viesturz/TapChanger-lite/README.md

# Tapchanger lite

Tapchanger lite is now the main [Tapchanger](https://github.com/viesturz/tapchanger), it's better in all ways and continues in the main repo.
