viesturz/TapChanger-lite/Images/dock.jpg

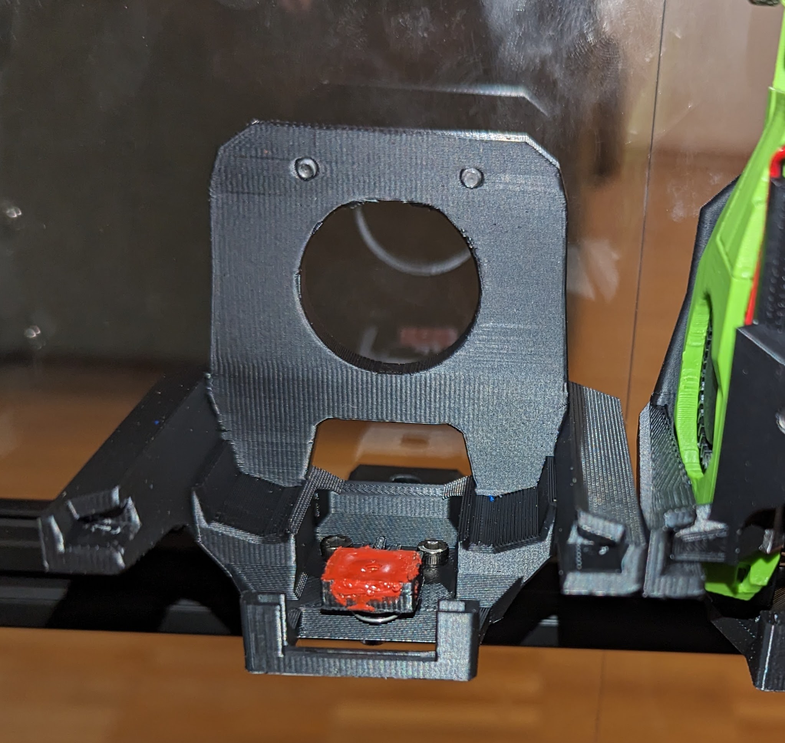
Images/dock.jpg
