viesturz/TapChanger-lite/Images/endstop_hub.jpg

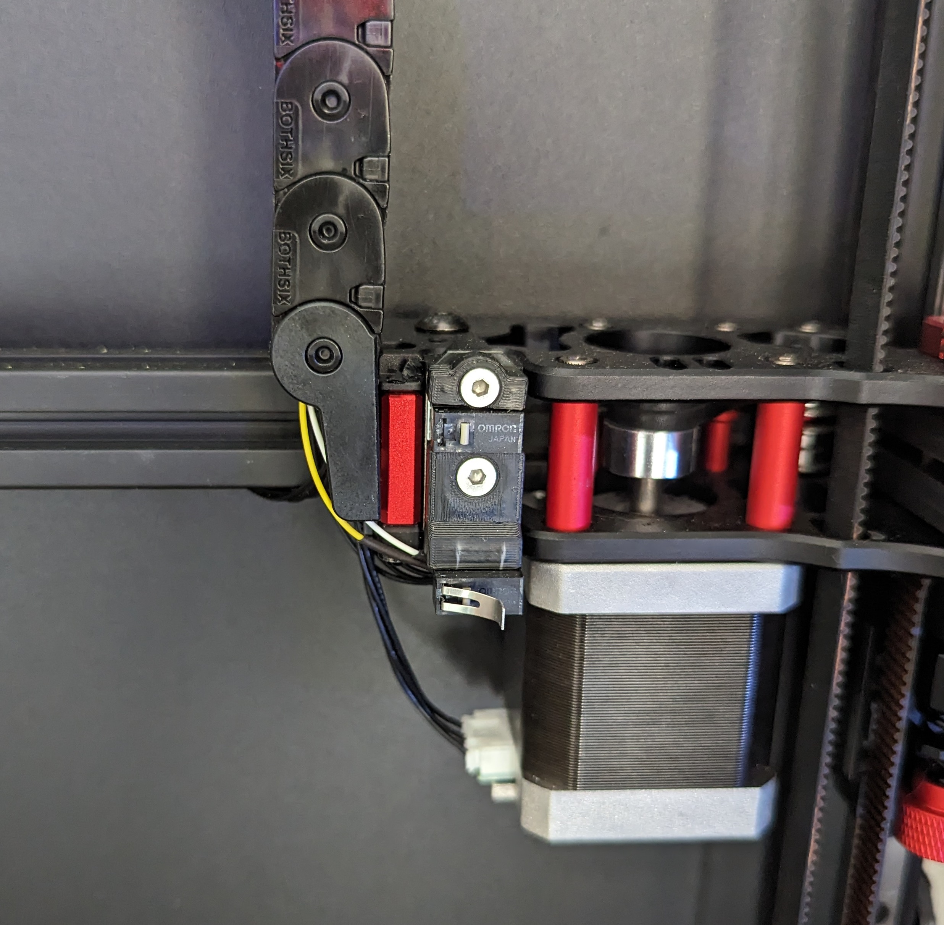
Images/endstop_hub.jpg
