viesturz/TapChanger-lite/Images/plate.jpg

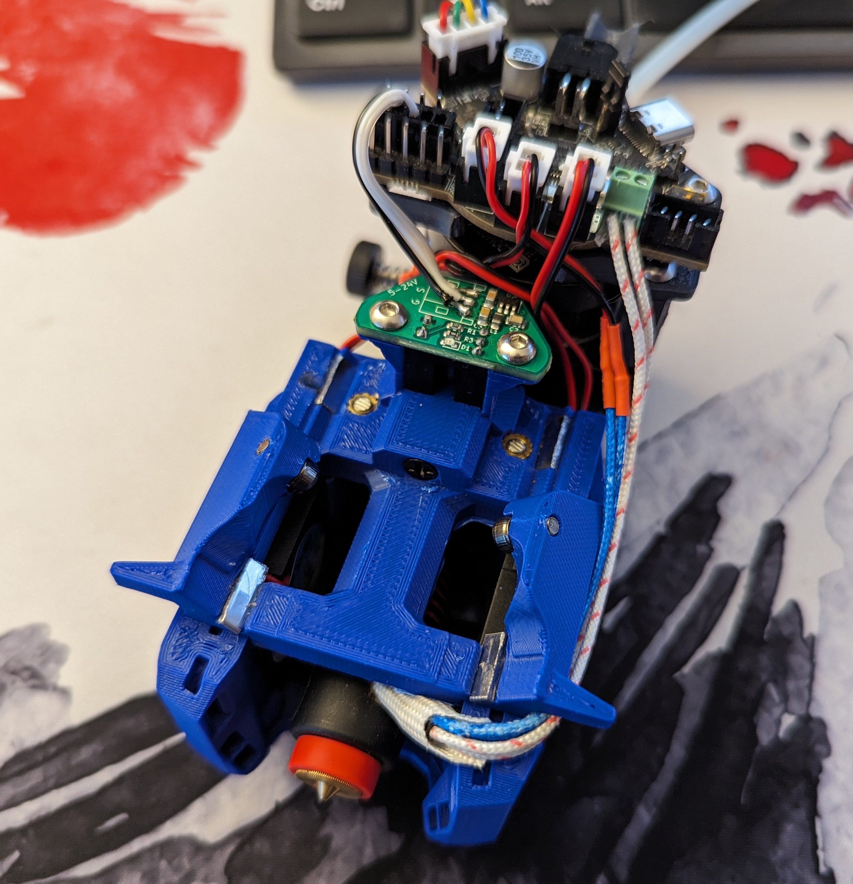
Images/plate.jpg
