viesturz/TapChanger-lite/Images/shuttle.jpg

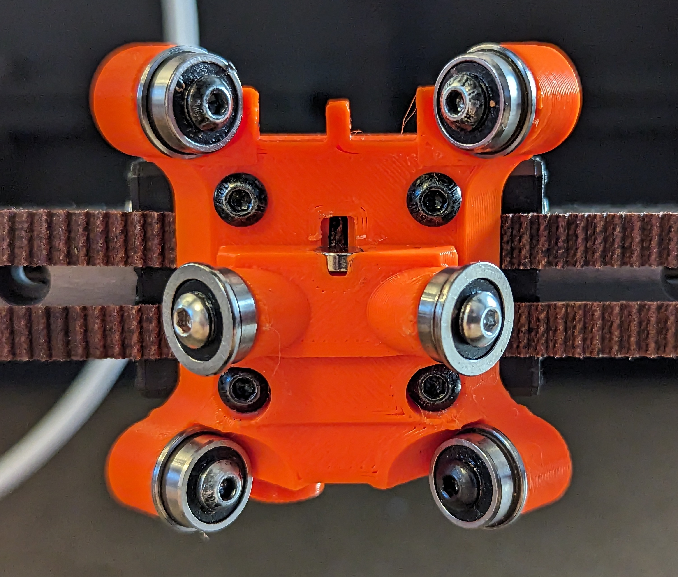
Images/shuttle.jpg
