viesturz/TapChanger-lite/STL/Endstops/HallSensor.stl

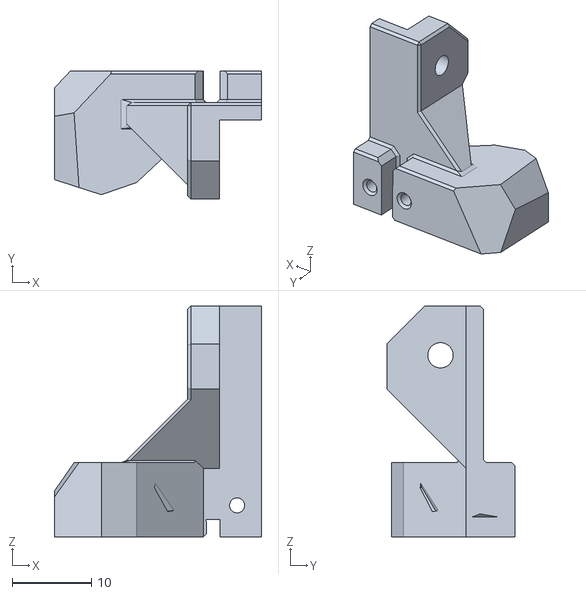
[picture p9: CAD file, 2023-08-19]
STL/Endstops/HallSensor.stl
26.2 x 16.2 x 29.2
