viesturz/TapChanger-lite/STL/MiniSB/Mount-rods.stl

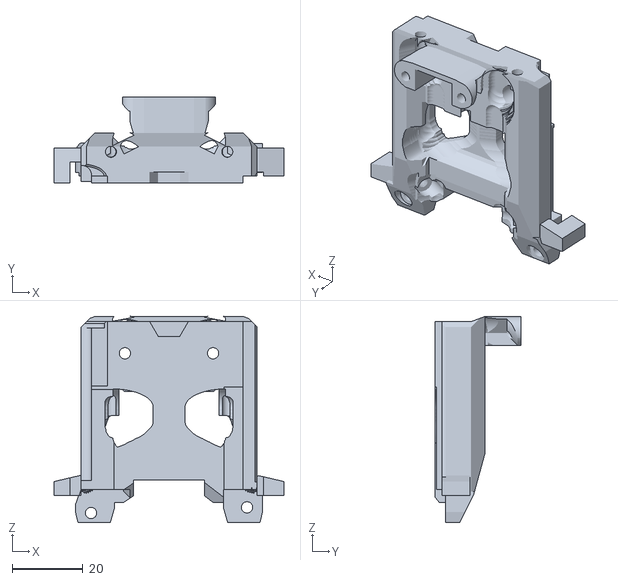
[picture p10: CAD file, 2023-09-16]
STL/MiniSB/Mount-rods.stl
65.2 x 24.4 x 58.5
