viesturz/TapChanger-lite/STL/Misc/RodCuttingJig2.stl

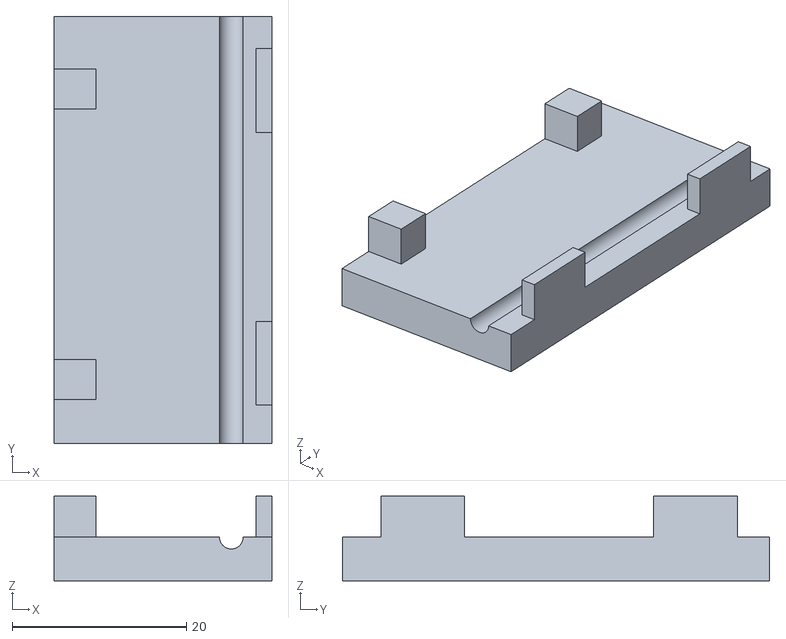
[picture p11: CAD file, 2023-08-30]
STL/Misc/RodCuttingJig2.stl
25.0 x 49.0 x 9.70
