viesturz/TapChanger-lite/STL/SB/Mount-rods.stl

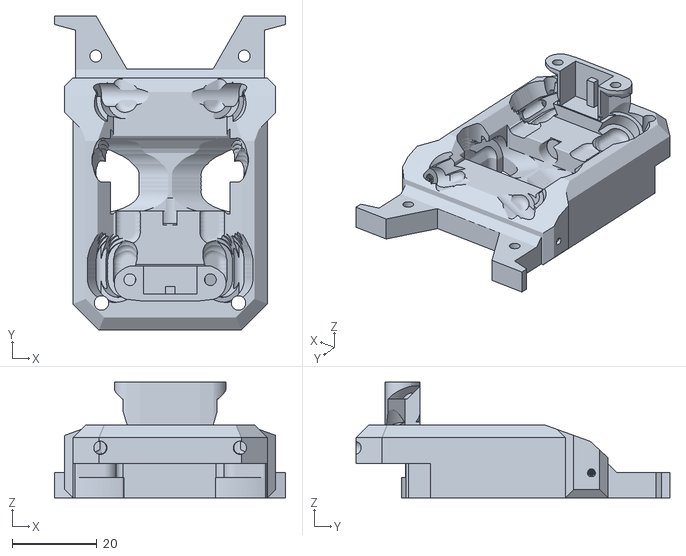
[picture p12: CAD file, 2023-09-16]
STL/SB/Mount-rods.stl
54.7 x 74.2 x 27.4
