viesturz/TapChanger-lite/STL/Shuttle/Shuttle-rods-thruholes.stl

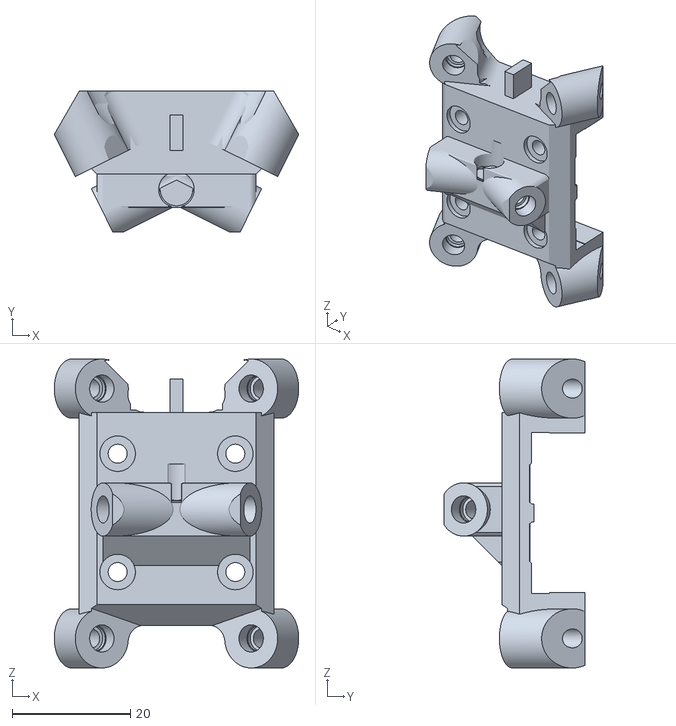
[picture p13: CAD file, 2023-09-16]
STL/Shuttle/Shuttle-rods-thruholes.stl
41.3 x 23.8 x 52.2
