viesturz/TapChanger-lite/STL/Endstops/ProbeHub Bottom Cap.stl

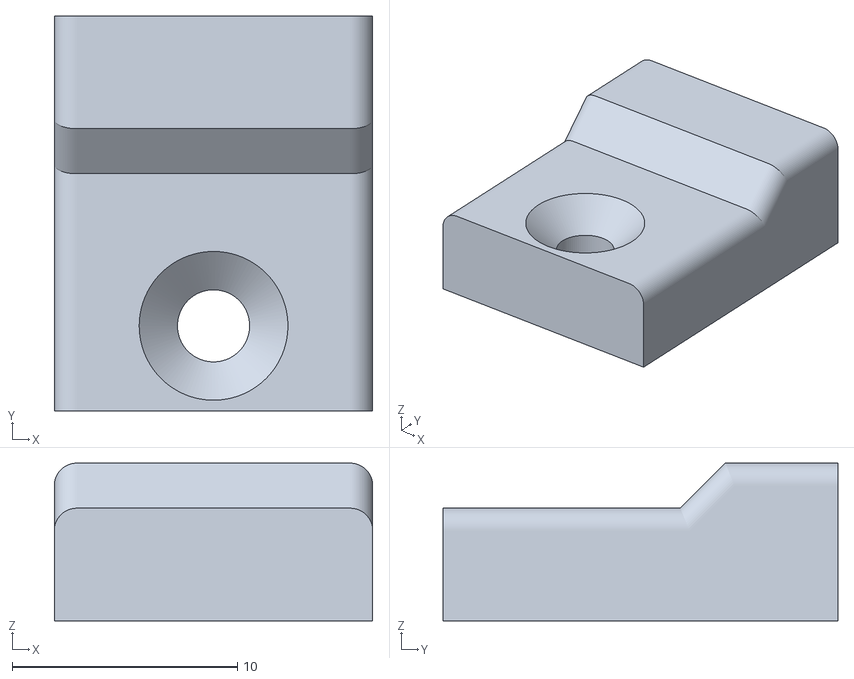
[picture p14: CAD file, 2023-07-01]
STL/Endstops/ProbeHub Bottom Cap.stl
14.1 x 17.5 x 7.00
