viesturz/TapChanger-lite/STL/MiniSB/Dock.stl

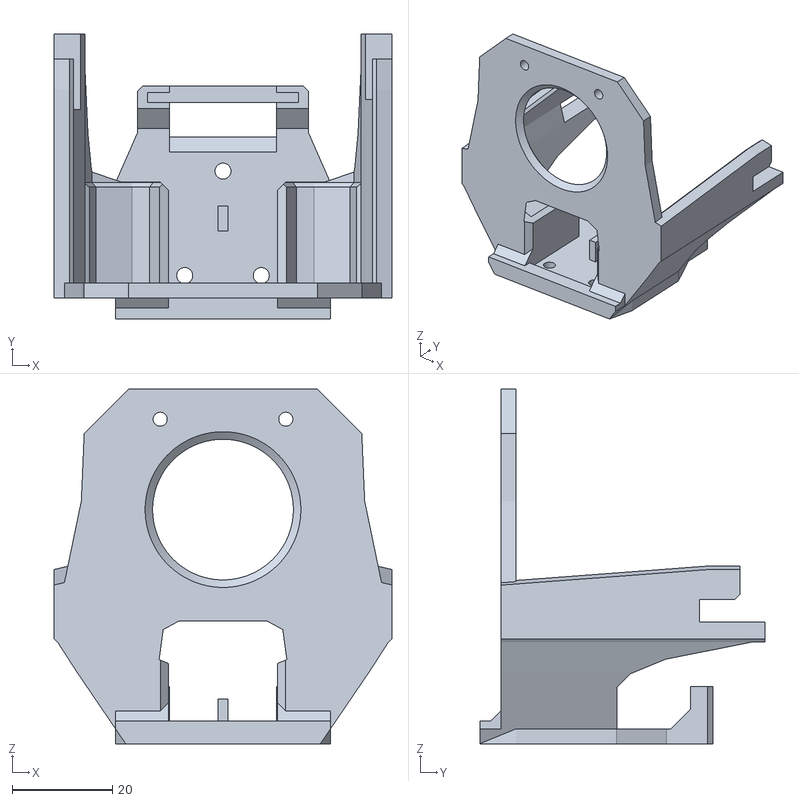
[picture p15: CAD file, 2023-07-29]
STL/MiniSB/Dock.stl
67.2 x 56.7 x 70.7
