viesturz/TapChanger-lite/STL/Misc/RodCuttingJig1.stl

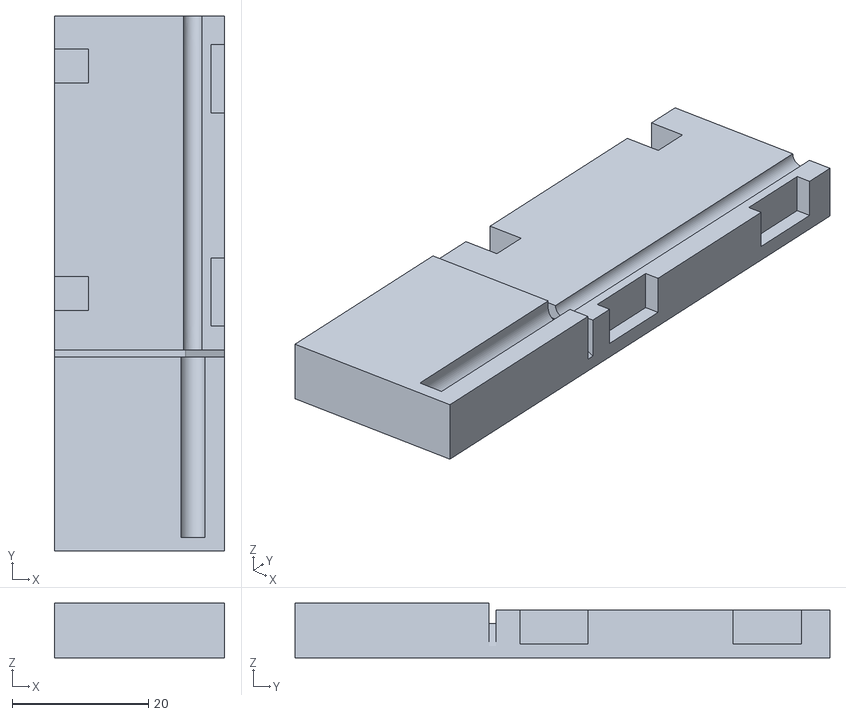
[picture p16: CAD file, 2023-08-30]
STL/Misc/RodCuttingJig1.stl
25.0 x 78.5 x 8.00
