viesturz/TapChanger-lite/STL/Shuttle/Shuttle-rods.stl

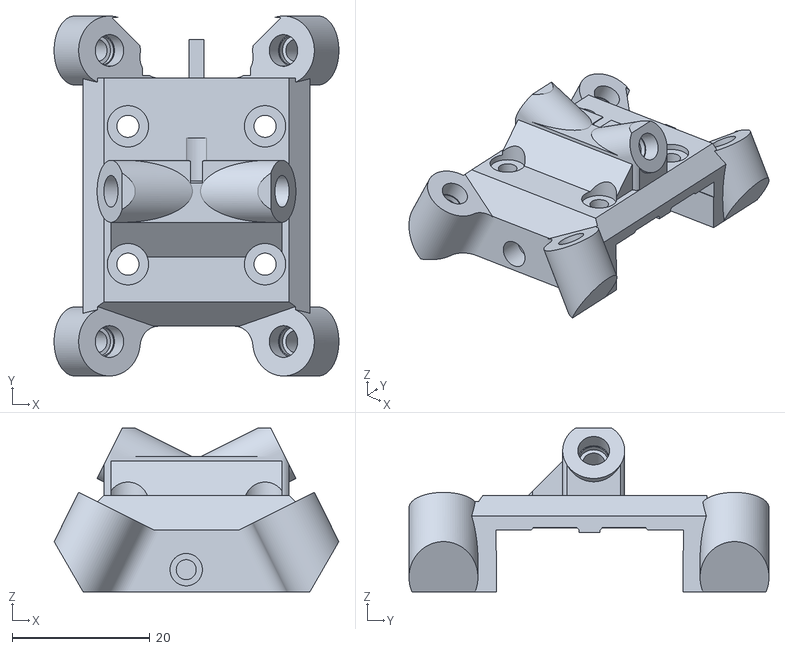
[picture p17: CAD file, 2023-09-16]
STL/Shuttle/Shuttle-rods.stl
41.3 x 52.2 x 23.8
