viesturz/TapChanger-lite/STL/Endstops/ProbeHub Top Cap.stl

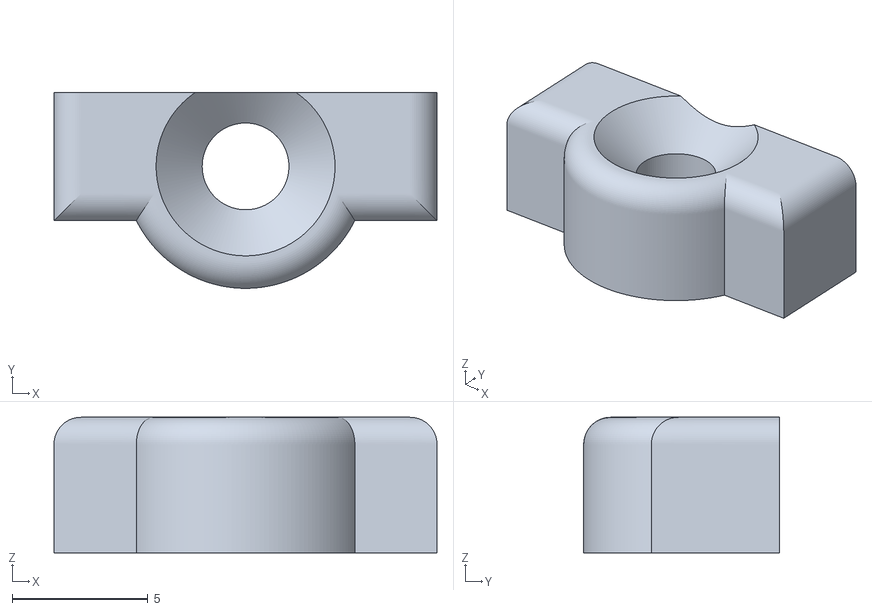
[picture p18: CAD file, 2023-07-01]
STL/Endstops/ProbeHub Top Cap.stl
14.1 x 7.22 x 5.00
