viesturz/TapChanger-lite/STL/MiniSB/Mount-pads.stl

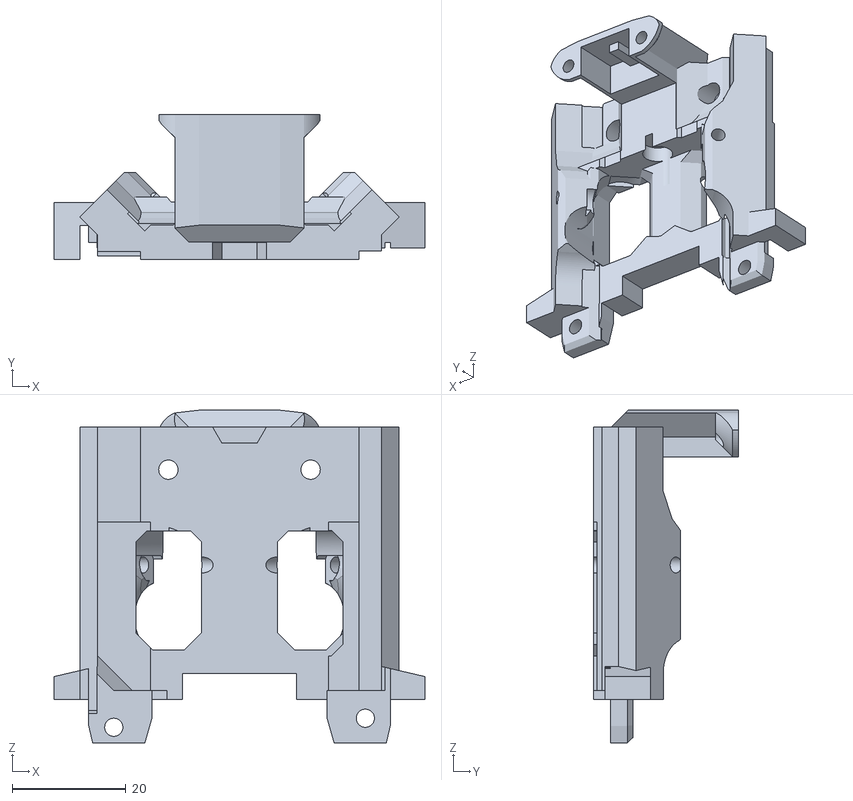
[picture p19: CAD file, 2023-07-01]
STL/MiniSB/Mount-pads.stl
65.2 x 25.4 x 58.5
