viesturz/TapChanger-lite/STL/Misc/PlateCuttingJig1.stl

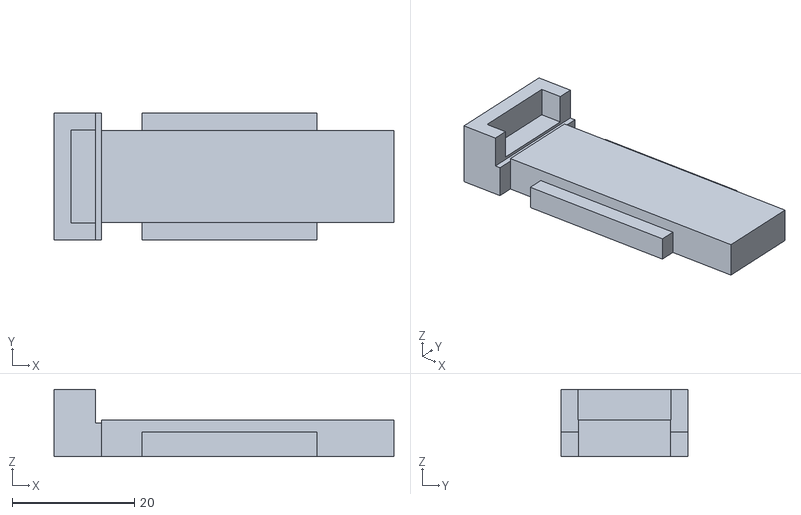
[picture p20: CAD file, 2023-07-29]
STL/Misc/PlateCuttingJig1.stl
55.6 x 20.8 x 11.0
