viesturz/TapChanger-lite/STL/SB/Dock.stl

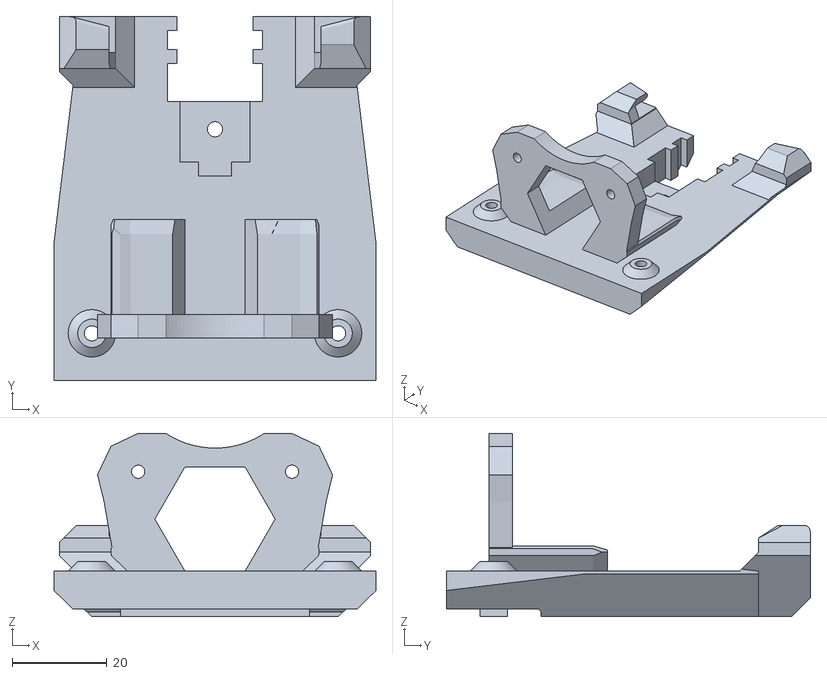
[picture p21: CAD file, 2023-07-29]
STL/SB/Dock.stl
68.0 x 76.9 x 38.7
