viesturz/TapChanger-lite/STL/Shuttle/Shuttle-pads.stl

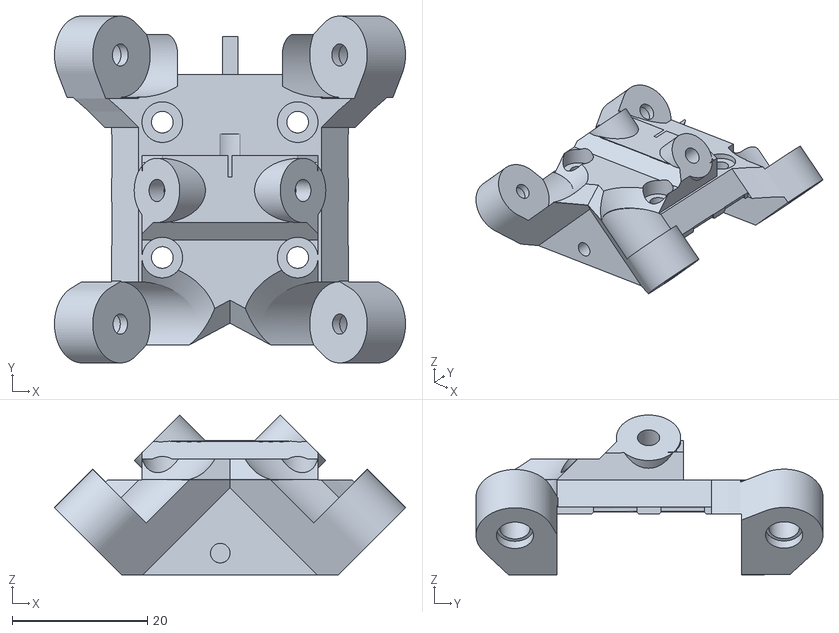
[picture p22: CAD file, 2023-07-01]
STL/Shuttle/Shuttle-pads.stl
51.9 x 51.3 x 23.6
