viesturz/TapChanger-lite/STL/Endstops/ProbeHub-Base.stl

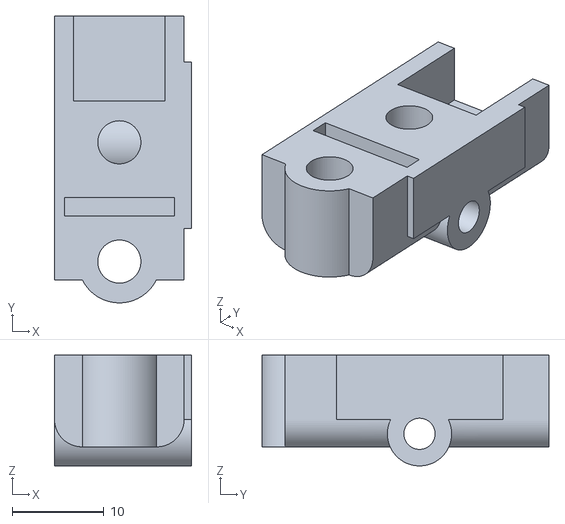
[picture p23: CAD file, 2023-07-01]
STL/Endstops/ProbeHub-Base.stl
14.9 x 31.2 x 12.1
