viesturz/TapChanger-lite/STL/MiniSB/DockMount.stl

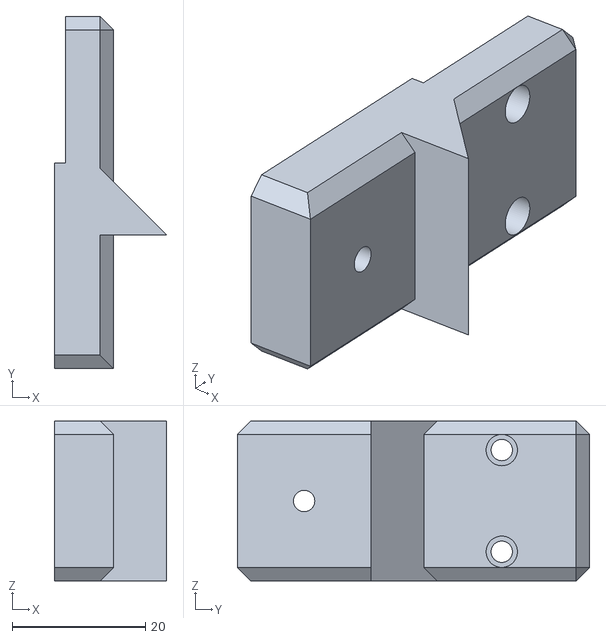
[picture p24: CAD file, 2023-06-28]
STL/MiniSB/DockMount.stl
16.9 x 52.8 x 24.0
