viesturz/TapChanger-lite/STL/Misc/PlateCuttingJig2.stl

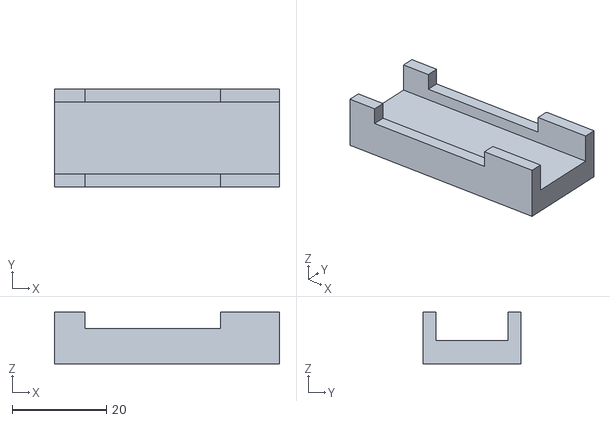
[picture p25: CAD file, 2023-07-29]
STL/Misc/PlateCuttingJig2.stl
47.8 x 20.8 x 11.0
