viesturz/TapChanger-lite/STL/SB/DockNozzlePad.stl

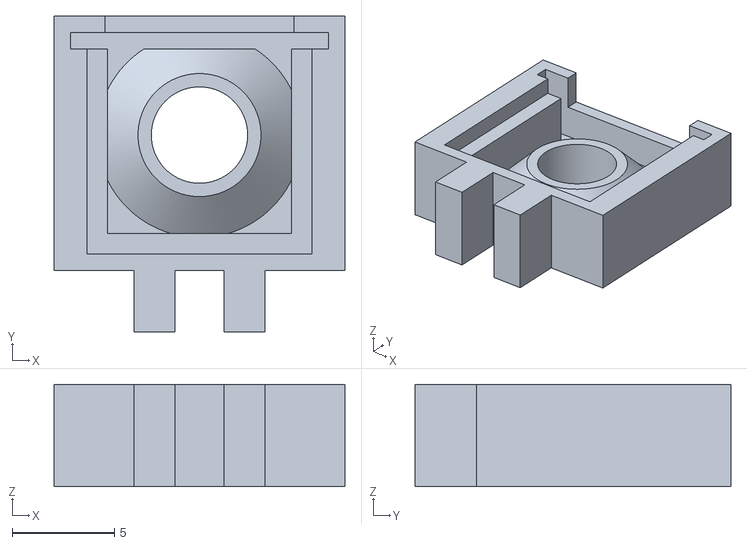
[picture p26: CAD file, 2023-06-25]
STL/SB/DockNozzlePad.stl
14.2 x 15.4 x 5.00
