viesturz/TapChanger-lite/STL/Endstops/X Endstop Lever.stl

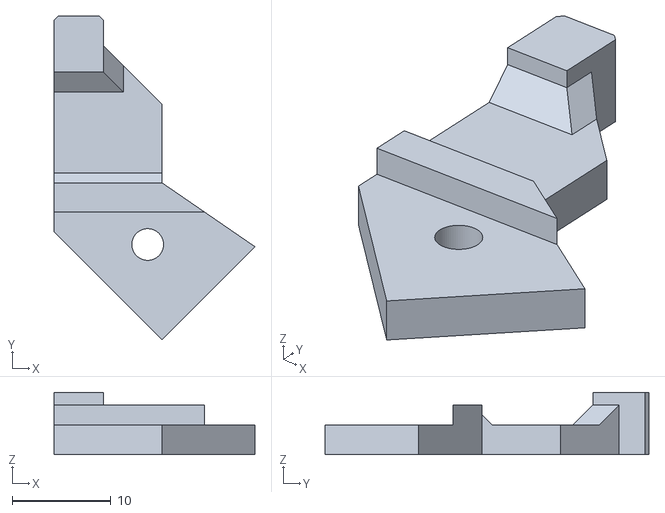
[picture p27: CAD file, 2023-06-25]
STL/Endstops/X Endstop Lever.stl
20.3 x 32.7 x 6.30
