viesturz/TapChanger-lite/STL/MiniSB/Front Cowling.stl

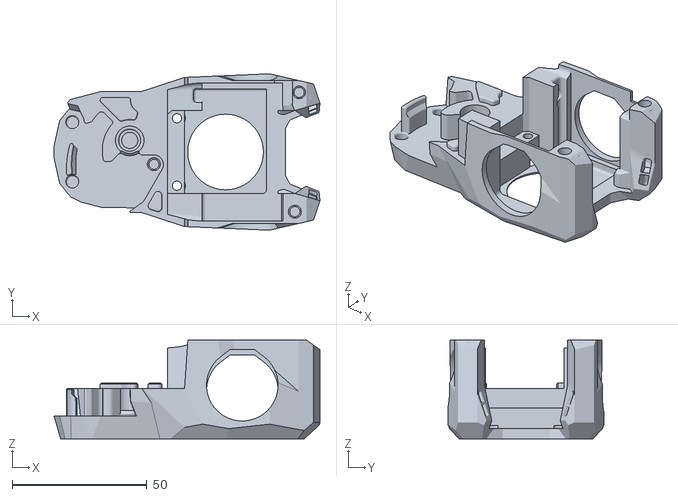
[picture p28: CAD file, 2023-06-28]
STL/MiniSB/Front Cowling.stl
98.6 x 57.9 x 36.5
