viesturz/TapChanger-lite/STL/MiniSB/Front Cowling-Orbiter 2.0.stl

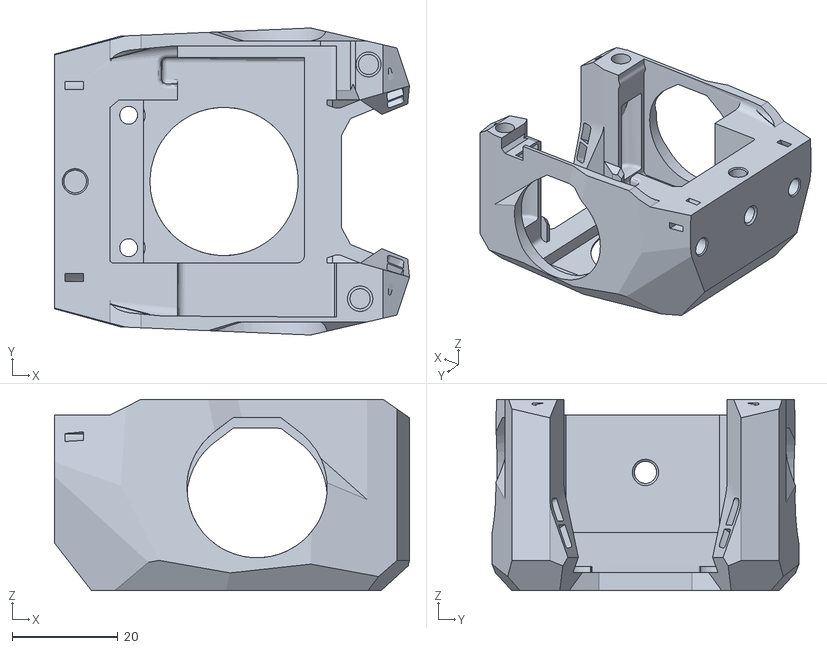
[picture p29: CAD file, 2023-06-28]
STL/MiniSB/Front Cowling-Orbiter 2.0.stl
67.0 x 57.9 x 36.1
