viesturz/TapChanger-lite/(list of files, cad)

Other CAD files:
STL/SB/Mount-pads.stl
STL/MiniSB/DockNozzlePad.stl
