viesturz/TapChanger-lite/(commit log)

2023-06-09 First rev
    [Dock-MiniSB.stl, DockMount-MiniSB.stl, Mount-MiniSB.stl, Shuttle.stl, XEndstop.stl]
2023-06-11 Small cleanups to shuttle.
    [Shuttle.stl]
2023-06-14 Minor rigidity updates, optional bottom screws into the cowling.
    [DockMount-MiniSB.stl, Front Cowling.stl]
2023-06-20 Minor updates to dock and plate.
    [Dock-MiniSB.stl, Dock.stl, DockMount-MiniSB.stl, DockMount.stl, Mount-MiniSB.stl, MountPlate.stl, Shuttle.stl]
2023-06-22 Unified mount - first attempt
    [Dock.stl, DockNozzlePad.stl, Front Cowling-Orbiter 2.0.stl, MountPlate.stl, Plate.stl, Shuttle.stl]
2023-06-24 This should work
    [DockBase_Lower.stl, DockBase_Upper.stl, DockNozzlePad.stl, Front Cowling.stl, MountPlate.stl, Plate.stl, Shuttle.stl, XEndstop.stl]
2023-06-24 Smaller Mini dock with magnets embedded in the cowling
    [Dock-Small.stl, Front Cowling.stl]
2023-06-25 Simplified dock for SB
    [Dock.stl, MountPlate.stl, Plate.stl, Shuttle.stl]
2023-06-25 Update orbiter, readme.
    [Front Cowling-Orbiter 2.0.stl]
2023-06-26 Longer sensor pin
    [Front Cowling-Orbiter 2.0.stl, MountPlate.stl, Plate.stl, Shuttle.stl]
2023-06-28 Tweaks for better printability, go back to the high mini dock, the small one is too flimsy.
    [Dock.stl, DockMount.stl, Front Cowling-Orbiter 2.0.stl, Front Cowling.stl, MountPlate.stl, Plate.stl, Shuttle.stl]
2023-07-01 Tighter heatset insert radius for shuttle bearings. The 45deg angle stretches out the standard radius.
    [Shuttle.stl]
2023-07-01 Fix plate bug.
    [MountPlate.stl, Plate.stl]
2023-07-01 1.1 - final fixes and add config.
    [Dock.stl, MountPlate.stl, Plate.stl, ProbeHub Bottom Cap.stl, ProbeHub Top Cap.stl, ProbeHub-Base.stl, X Endstop Lever.stl, XEndstop.stl]
2023-07-01 Update Print Guide.md
2023-07-02 Dock tweaks
    [Dock.stl]
2023-07-05 Fix SB hole sizes
    [Plate.stl]
2023-07-08 Migrate config to https://github.com/viesturz/klipper/tree/toolchanger
    [calibrate-offsets.cfg, homing.cfg, macros.cfg, mcu-mini-T0.cfg, mcu-mini-T1.cfg, mcu-mini-plain-T3.cfg, mcu-sb-T2.cfg, mcu.cfg]
2023-07-29 Updated SB dock + Plate cutting jig
    [Dock.stl, DockBase_Lower.stl, DockBase_Upper.stl, PlateCuttingJig1.stl, PlateCuttingJig2.stl]
2023-07-29 Add some tolerance for supported area, otherwise this is very tight fit.
    [Plate.stl]
2023-08-19 Add hall X sensor mount
    [HallSensor.stl]
2023-08-19 Orientation fix
    [HallSensor.stl]
2023-08-20 Testing rods.
    [Mount.stl, Shuttle.stl]
2023-08-22 Tweks for better fit.
    [Mount.stl, Shuttle.stl]
2023-08-25 Rods V1 - testing can begin
    [Mount-pads.stl, Mount-rods.stl, Mount.stl, MountPlate.stl, Plate.stl, Shuttle-pads.stl, Shuttle-rods.stl, Shuttle.stl]
2023-08-25 Update readme.
    [Mount-rods.stl]
2023-08-25 Update BOM and description for rods.
2023-08-26 SB Rods tweaks.
    [Mount-rods.stl, Shuttle-rods.stl]
2023-08-26 Tiny tweaks
    [Mount-rods.stl]
2023-08-26 Updated klipper config
    [calibrate-offsets.cfg, homing.cfg, macros.cfg, mcu-mini-T0.cfg, mcu-mini-T1.cfg, mcu-mini-plain-T3.cfg, mcu-sb-T2.cfg, mcu-sb-T4.cfg]
2023-08-30 Rod holes fix.
    [Mount-pads.stl, Mount-rods.stl, RodCuttingJig1.stl, RodCuttingJig2.stl]
2023-08-30 Fix slack between magnets
    Fix 0.7mm extra slack between shuttle and plate. The two sides should make contact at the flat face where magnets are.
    Also reduce the magnet socket depth from 3.5 to 3.1, so the magnets should connect precisely now.
    [Mount-rods.stl, Shuttle-rods.stl]
2023-08-30 Fix too deep magnet pocket (again)
    [Mount-rods.stl]
2023-08-31 Printability tweaks for rods.
    [Mount-rods.stl, Shuttle-rods.stl]
2023-09-01 Add a thru holes version for shuttle.
    [Shuttle-rods-thruholes.stl]
2023-09-02 Trim some plastic interfering with opto sensor on the shutle.
    [Shuttle-rods-thruholes.stl, Shuttle-rods.stl]
